VGCH/IV26_device/img/корпус.jpg

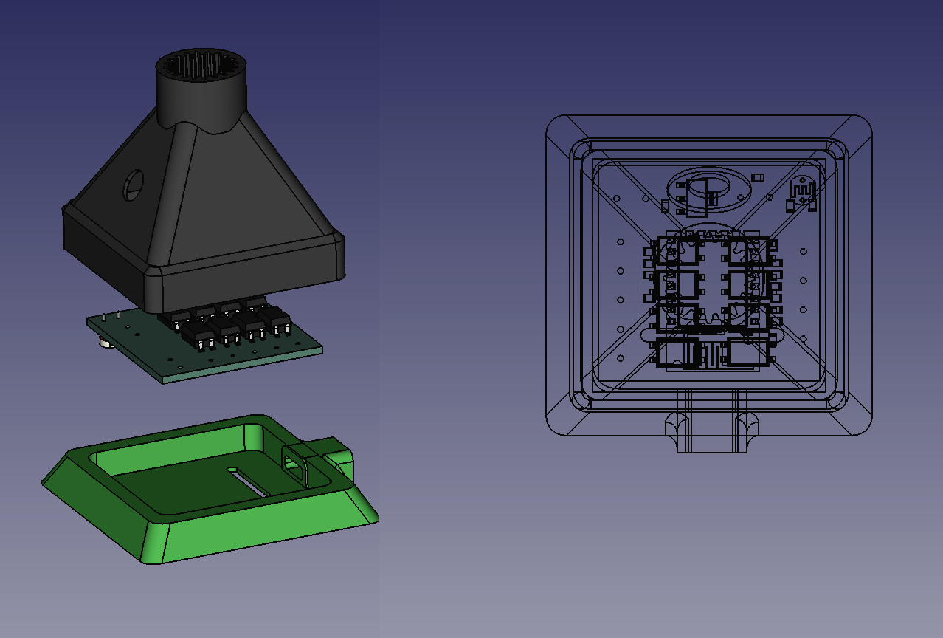
img/корпус.jpg
