VGCH/IV26_device/img/тест_лампы.jpg

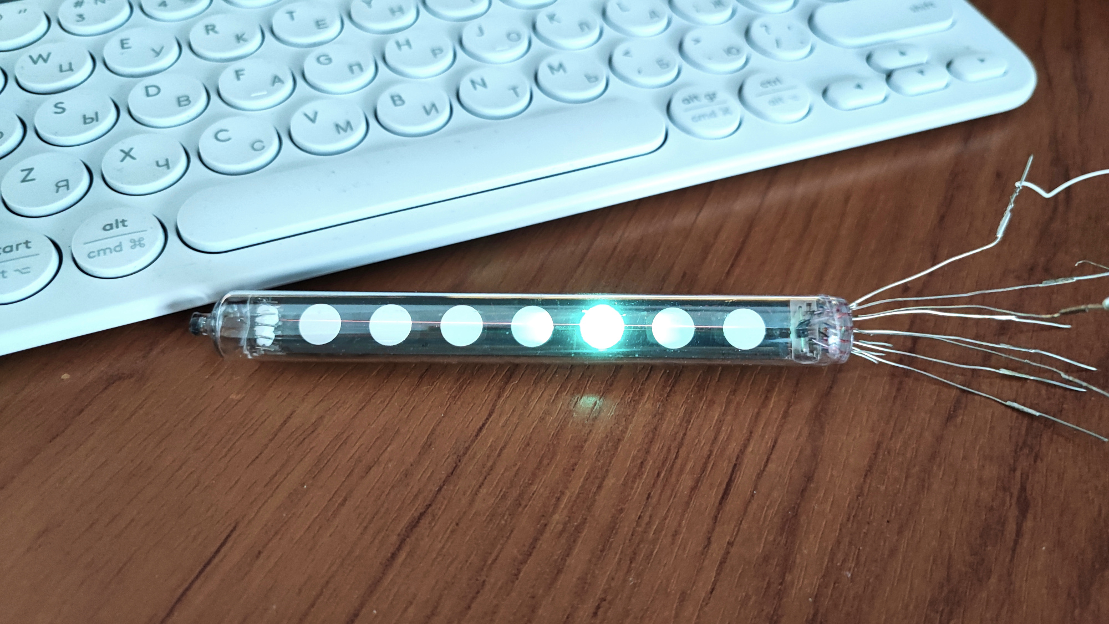
img/тест_лампы.jpg
