VGCH/IV26_device/img/IV26_giagram.png

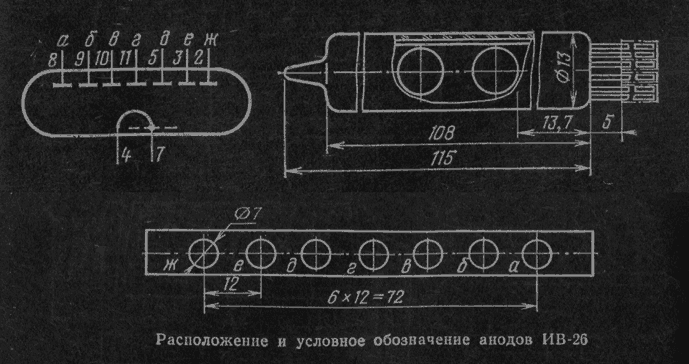
img/IV26_giagram.png
