VGCH/IV26_device/img/горящая_лампа.jpg

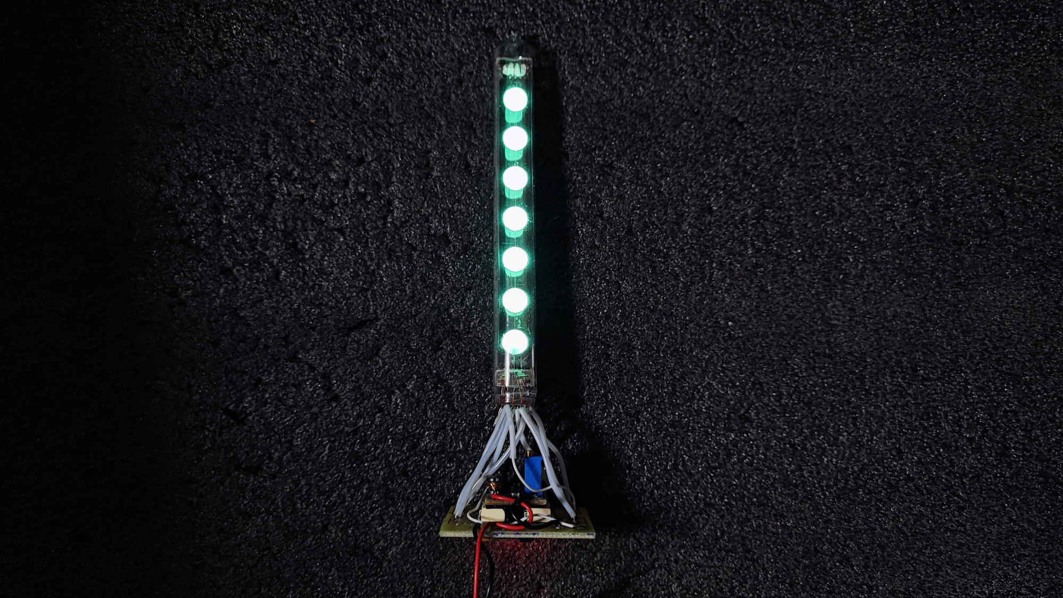
img/горящая_лампа.jpg
