VGCH/IV26_device/img/готовое.jpg

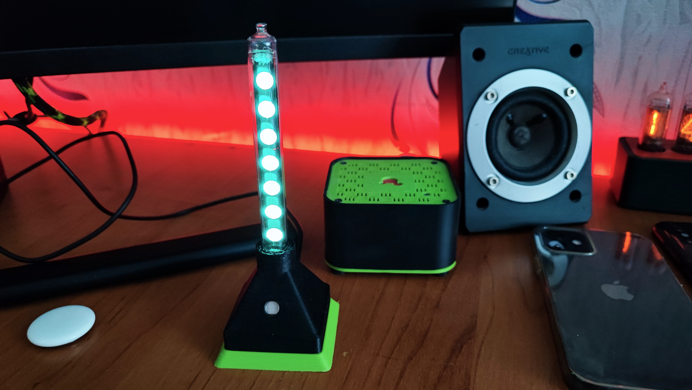
img/готовое.jpg
