VGCH/IV26_device/img/засветка_лазером.jpg

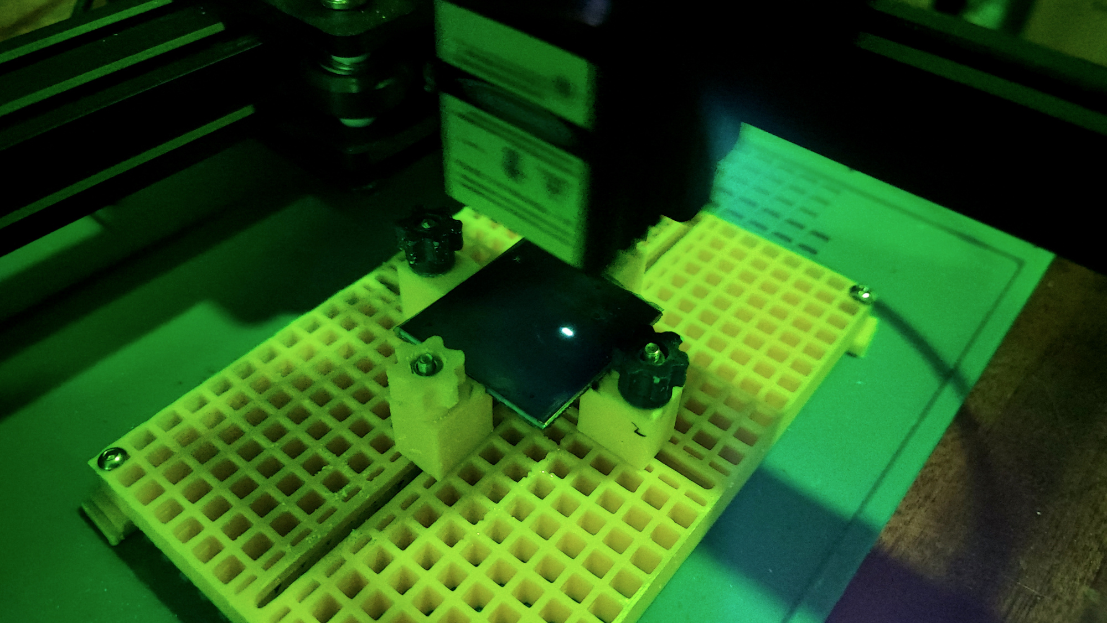
img/засветка_лазером.jpg
