VGCH/IV26_device/img/засвеченная_плата.jpg

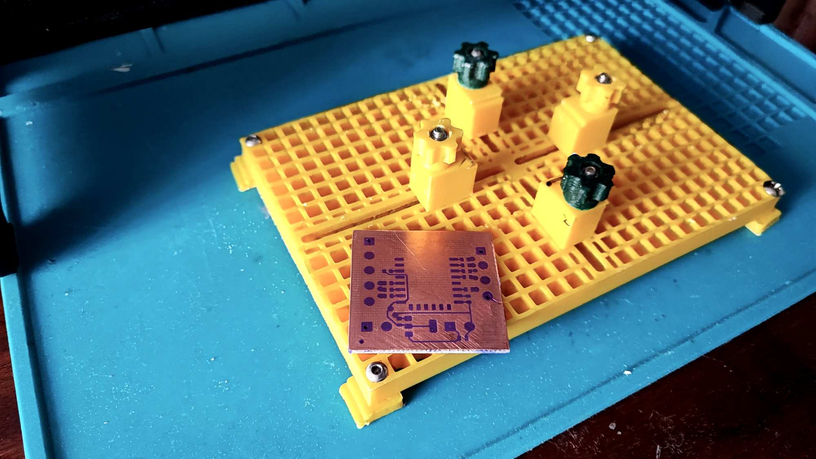
img/засвеченная_плата.jpg
