VGCH/IV26_device/img/интерфейс1.jpg

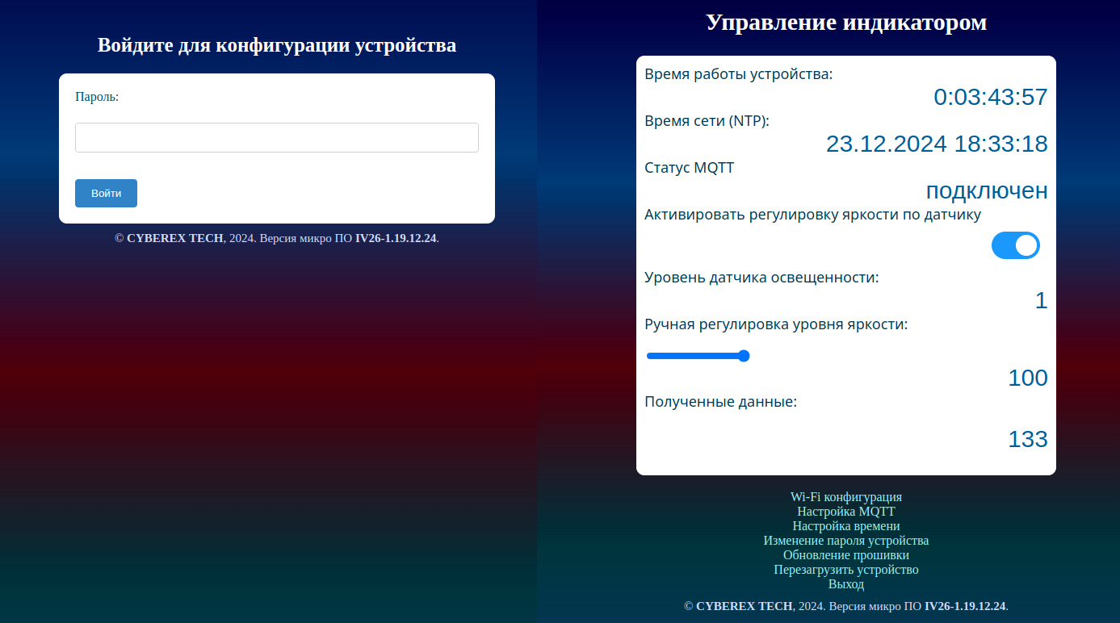
img/интерфейс1.jpg
