VGCH/IV26_device/img/интерфейс2.jpg

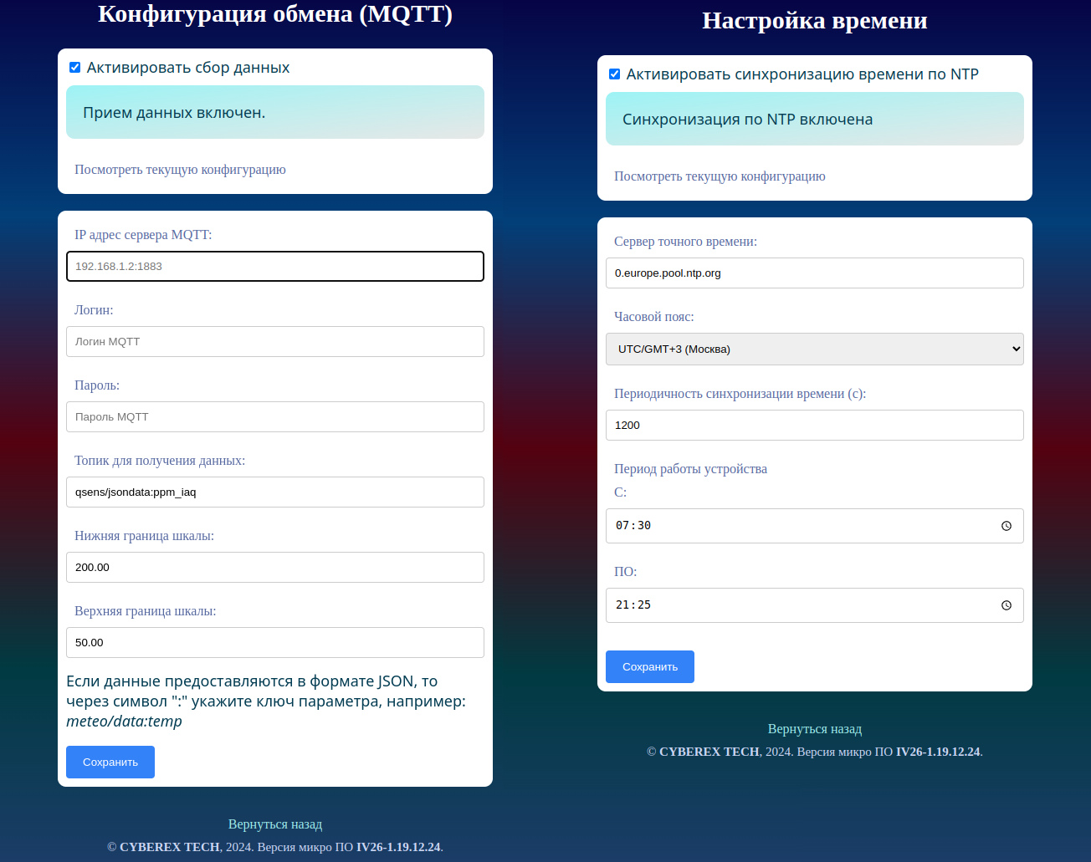
img/интерфейс2.jpg
