VGCH/IV26_device/img/лампа_общий_вид.jpg

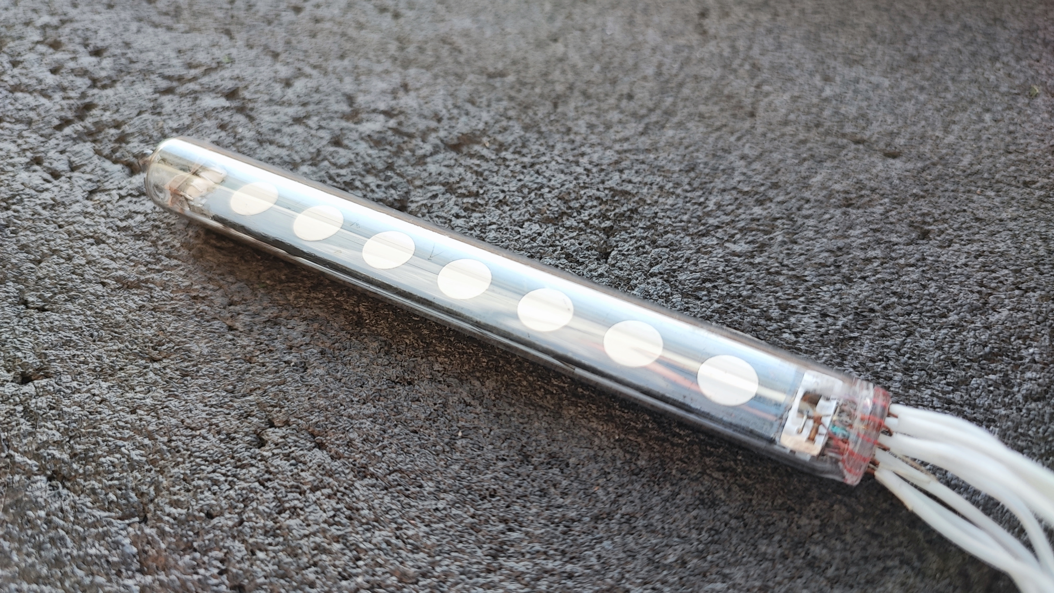
img/лампа_общий_вид.jpg
