VGCH/IV26_device/img/лампа_общий_вид_2.jpg

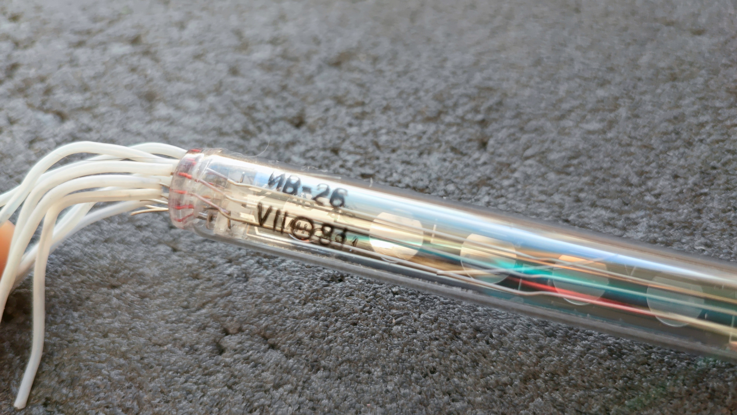
img/лампа_общий_вид_2.jpg
