VGCH/IV26_device/img/Око_Саурона.jpg

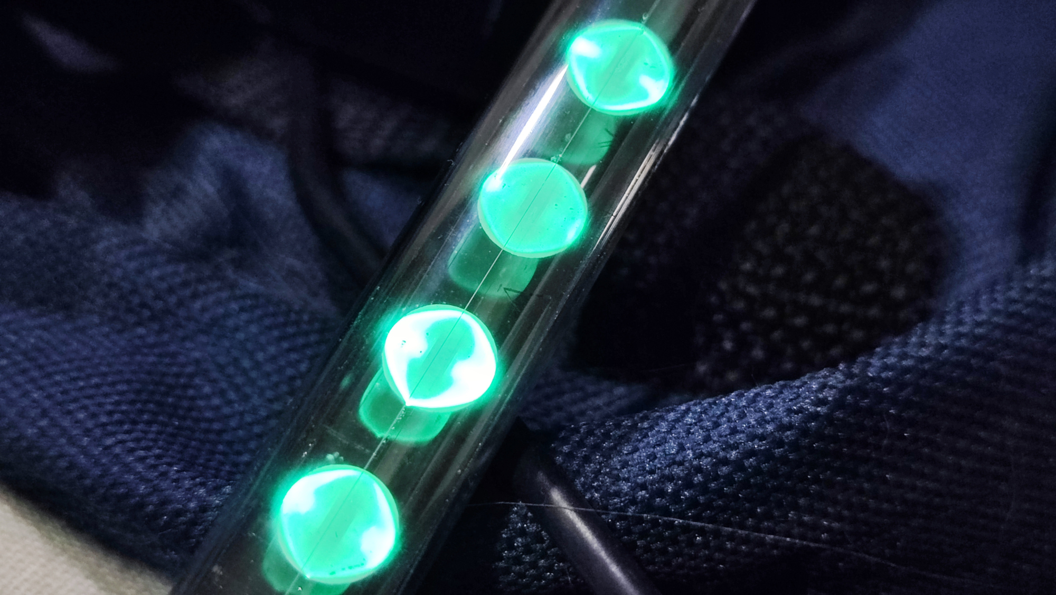
img/Око_Саурона.jpg
