VGCH/IV26_device/img/параметры_ИВ26.jpg

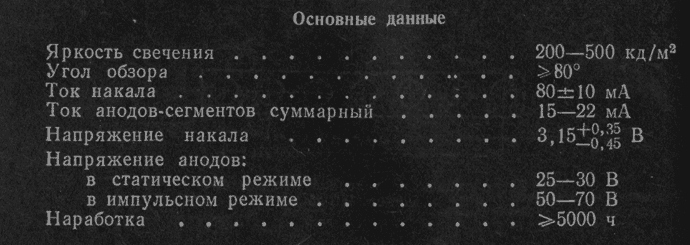
img/параметры_ИВ26.jpg
