VGCH/IV26_device/img/плата.jpg

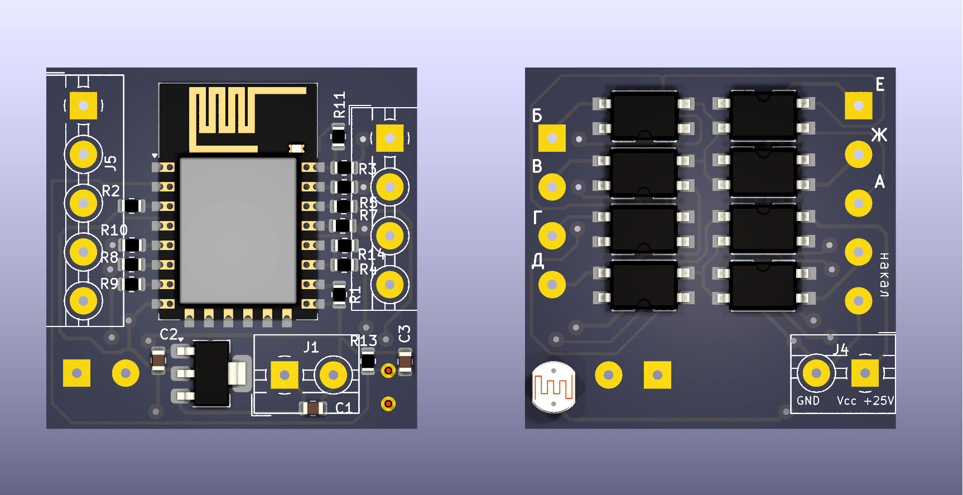
img/плата.jpg
