VGCH/IV26_device/img/подключаем_лампу.jpg

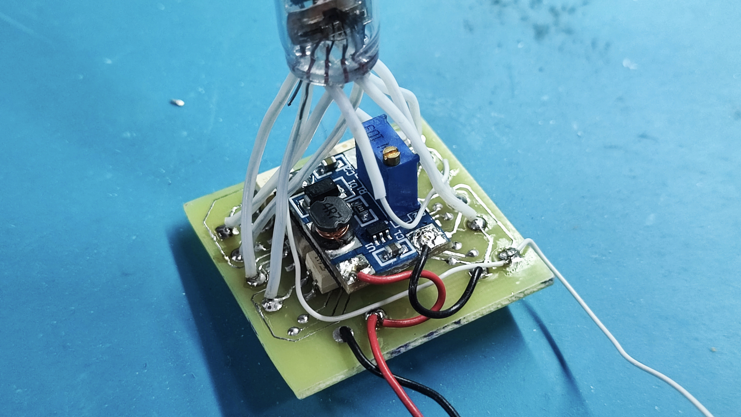
img/подключаем_лампу.jpg
