VGCH/IV26_device/img/подключаем_лампу_виз_сбоку.jpg

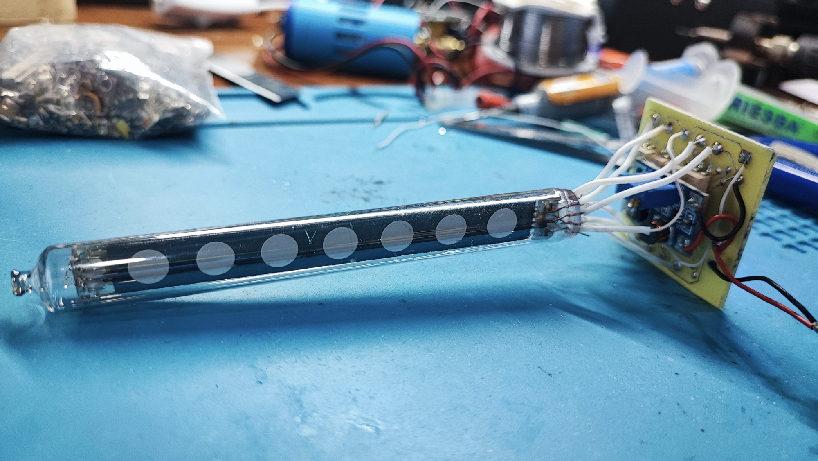
img/подключаем_лампу_виз_сбоку.jpg
