VGCH/IV26_device/img/преобразователь.jpg

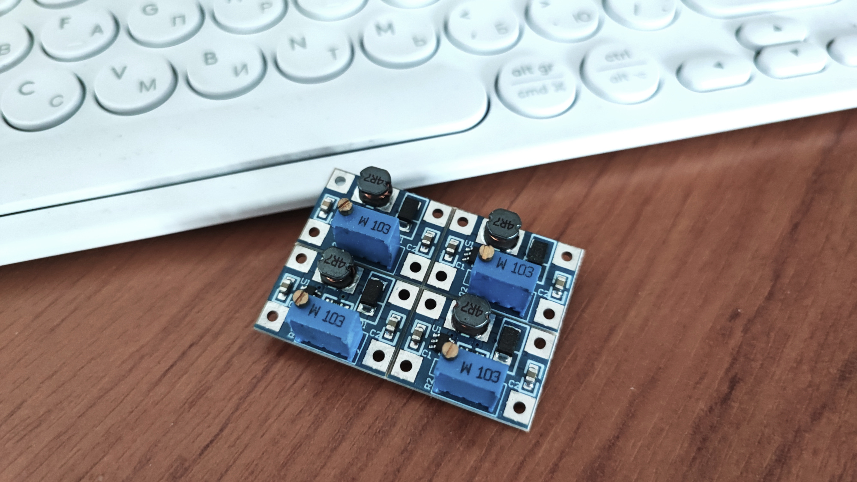
img/преобразователь.jpg
