VGCH/IV26_device/img/сборка_платы_зад.jpg

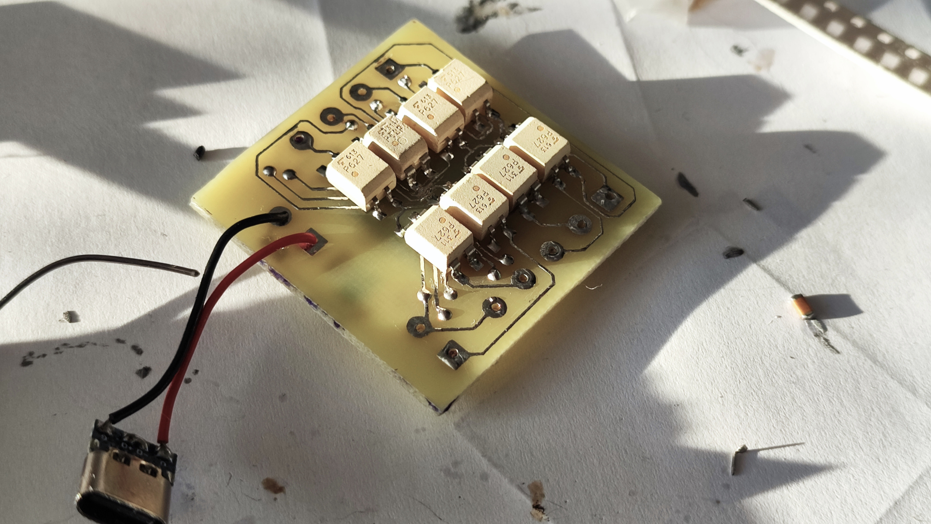
img/сборка_платы_зад.jpg
