VGCH/IV26_device/img/сборка_платы_топ.jpg

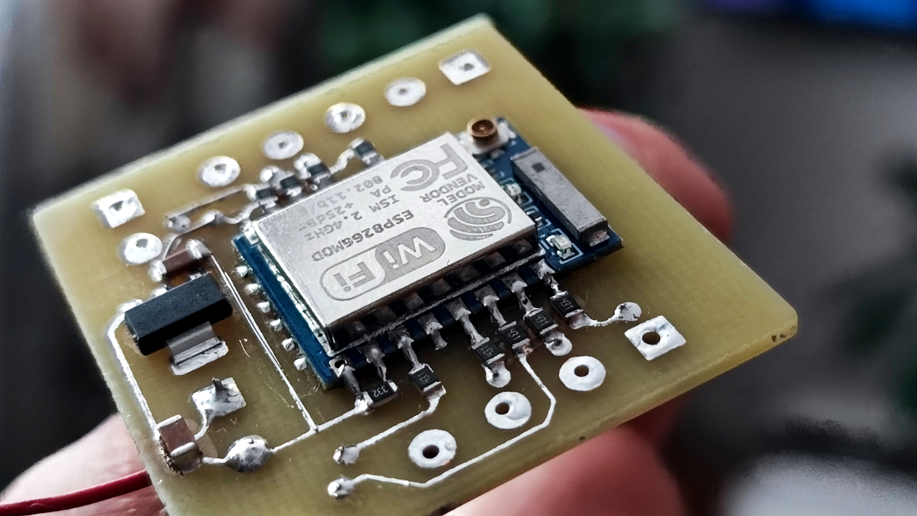
img/сборка_платы_топ.jpg
