VGCH/IV26_device/img/Снимок экрана 2024-12-23 в 19.39.56.png

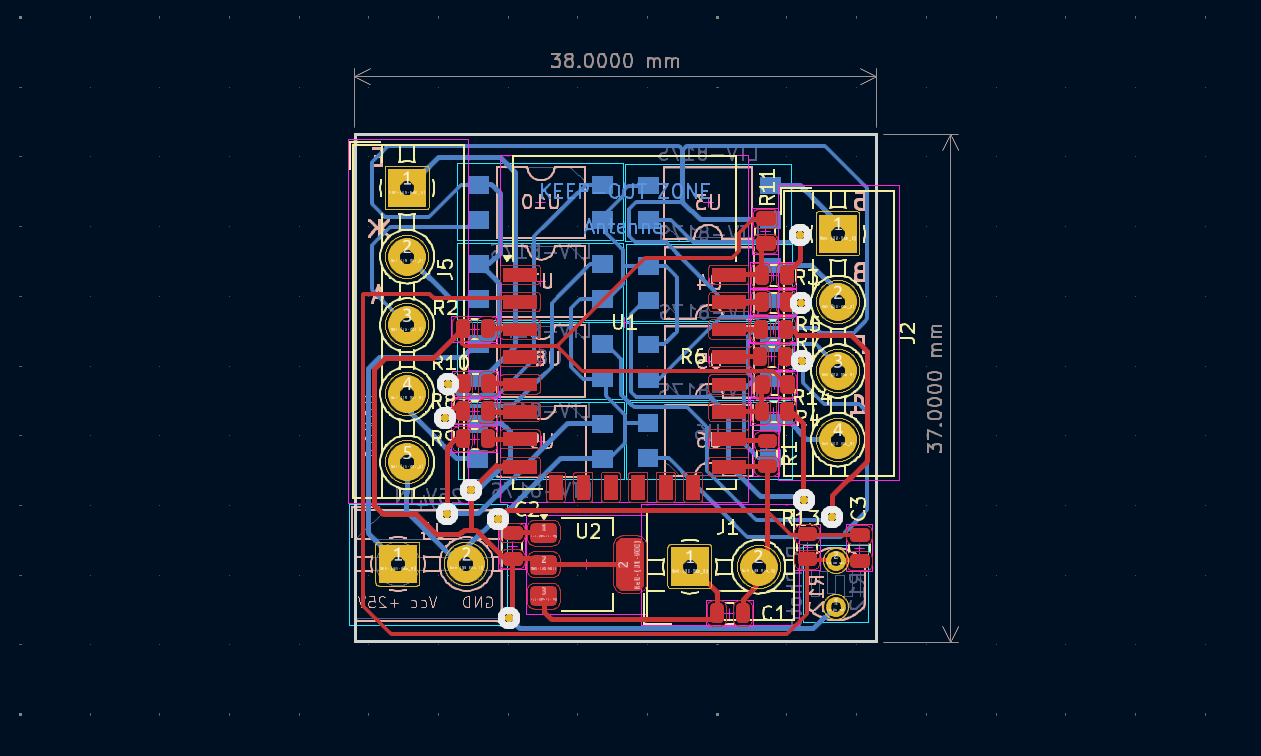
img/Снимок экрана 2024-12-23 в 19.39.56.png
