VGCH/IV26_device/img/схема.jpg

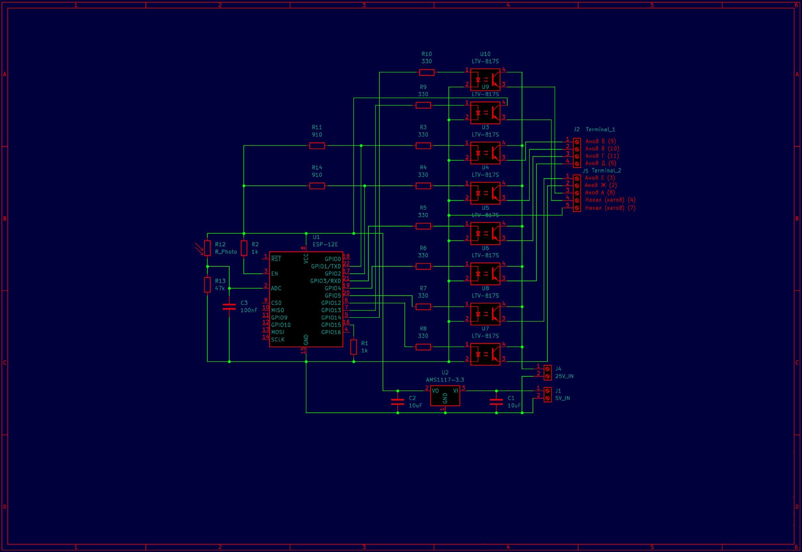
img/схема.jpg
