VGCH/IV26_device/img/фото_резистор.jpg

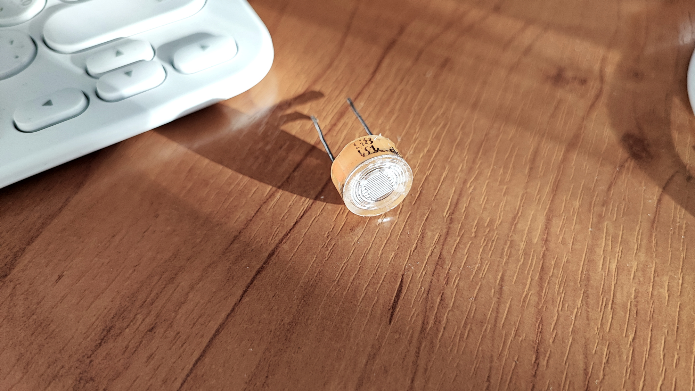
img/фото_резистор.jpg
