VGCH/IV26_device/IV26_board/IV26_board_back.png

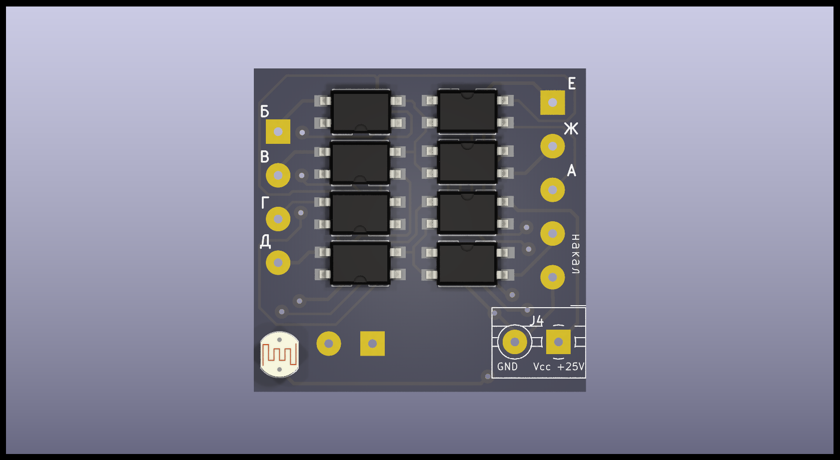
IV26_board/IV26_board_back.png
