VGCH/IV26_device/IV26_board/IV26_board_top.png

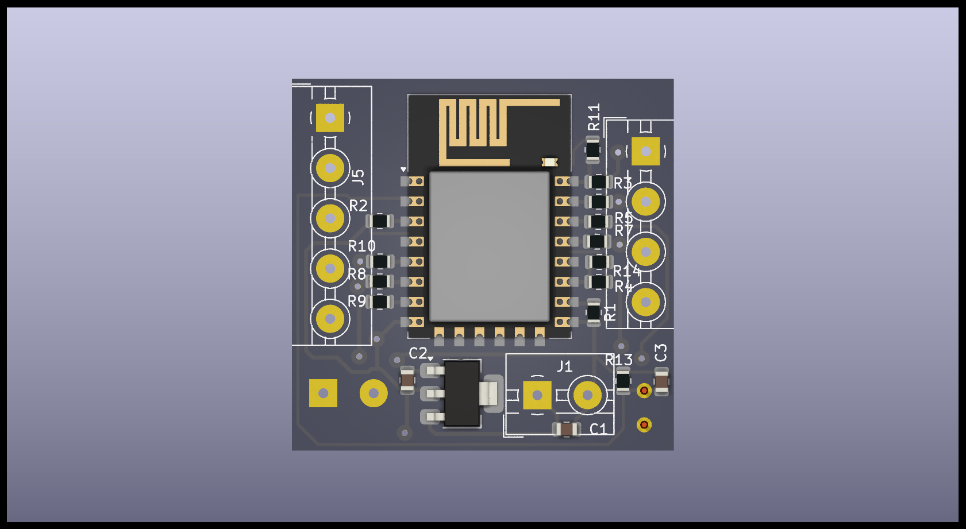
IV26_board/IV26_board_top.png
