VGCH/IV26_device/box/IV26_indicator.FCStd

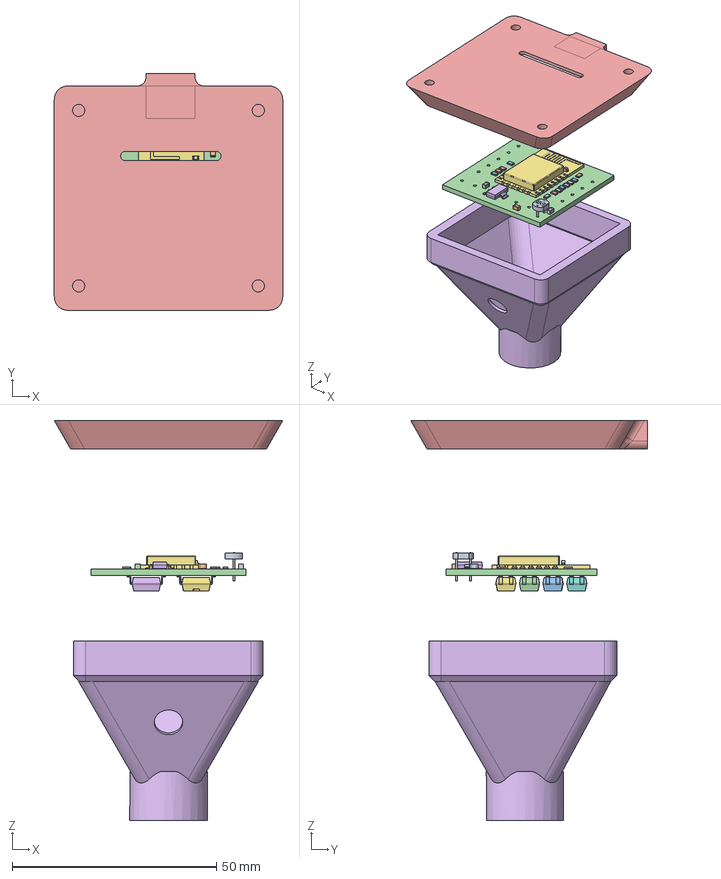
[picture p25: CAD file, 2024-12-24]
box/IV26_indicator.FCStd
56.0 x 58.0 x 98.0 mm
R_0805_2012Metric
R_0805_2012Metric002
R_0805_2012Metric004
R_0805_2012Metric006
R_0805_2012Metric008
SOT_223
R_0805_2012Metric010
R_0805_2012Metric012
C_0805_2012Metric
R_0805_2012Metric014
R_0805_2012Metric016
C_0805_2012Metric002
R_0805_2012Metric018
R_0805_2012Metric020
ESP_12E001_cp
R_0805_2012Metric022
R_LDR_5.1x4.3mm_P3.4mm_Vertical
C_0805_2012Metric004
R_0805_2012Metric024
SMDIP_4_W953mm
SMDIP_4_W953mm001
SMDIP_4_W953mm002
SMDIP_4_W953mm003
SMDIP_4_W953mm004
SMDIP_4_W953mm005
SMDIP_4_W953mm006
SMDIP_4_W953mm007
IV26_board_PCB
