VGCH/IV26_device/box/STL/IV26_indicator-bot.stl

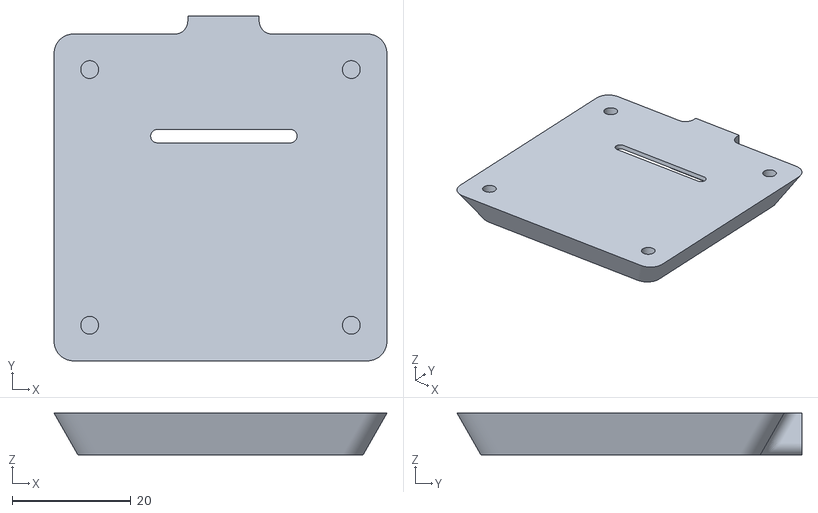
[picture p26: CAD file, 2024-12-24]
box/STL/IV26_indicator-bot.stl
56.0 x 58.0 x 7.00
