VGCH/IV26_device/IV26_board/IV26_board.step

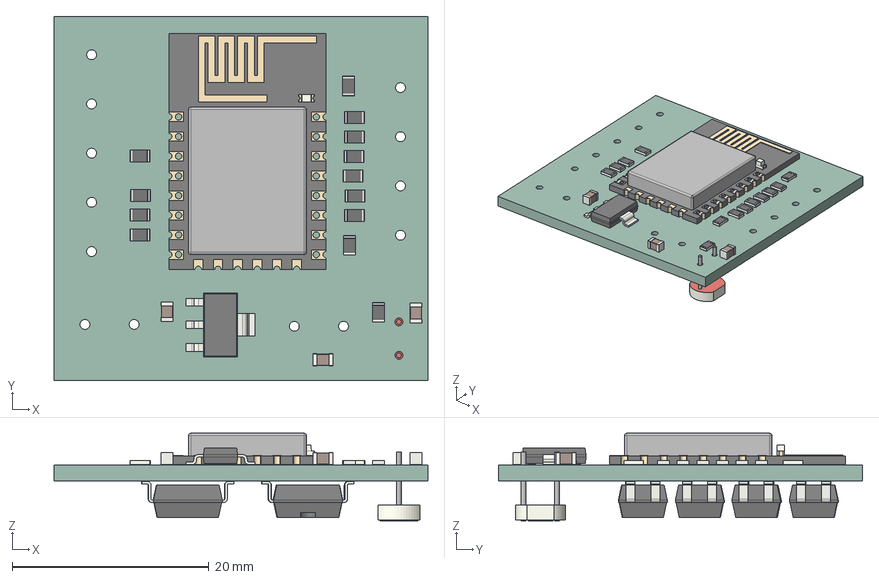
[picture p27: CAD file, 2024-12-24]
IV26_board/IV26_board.step
38.0 x 37.0 x 8.90 mm
R_0805_2012Metric x 13
SOT_223
C_0805_2012Metric x 3
ESP_12E001_cp
SMDIP_4_W953mm x 8
R_LDR_5.1x4.3mm_P3.4mm_Vertical
IV26_board_PCB
