VGCH/IV26_device/box/STL/IV26_indicator-Cut003.stl

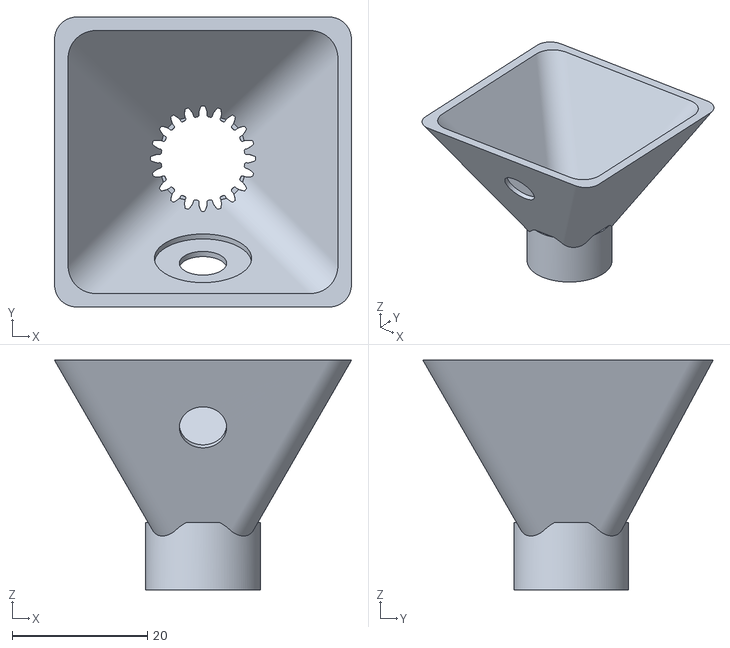
[picture p28: CAD file, 2024-12-24]
box/STL/IV26_indicator-Cut003.stl
44.0 x 43.0 x 34.0
