VGCH/IV26_device/box/STL/IV26_indicator-Chamfer.stl

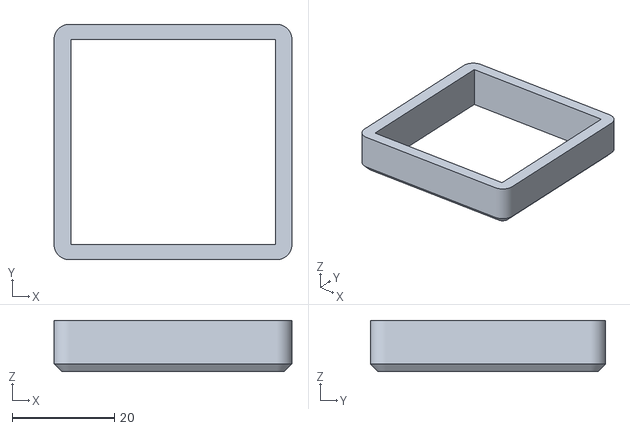
[picture p29: CAD file, 2024-12-24]
box/STL/IV26_indicator-Chamfer.stl
46.5 x 46.0 x 10.0
