VGCH/IV26_device/(list of files, cad)

Other CAD files:
box/STL/IV26_indicator.stl
