VGCH/IV26_device/IV26_board/IV26_board.kicad_pcb

## KiCad design IV26_board/IV26_board.kicad_pcb (2024-12-24)

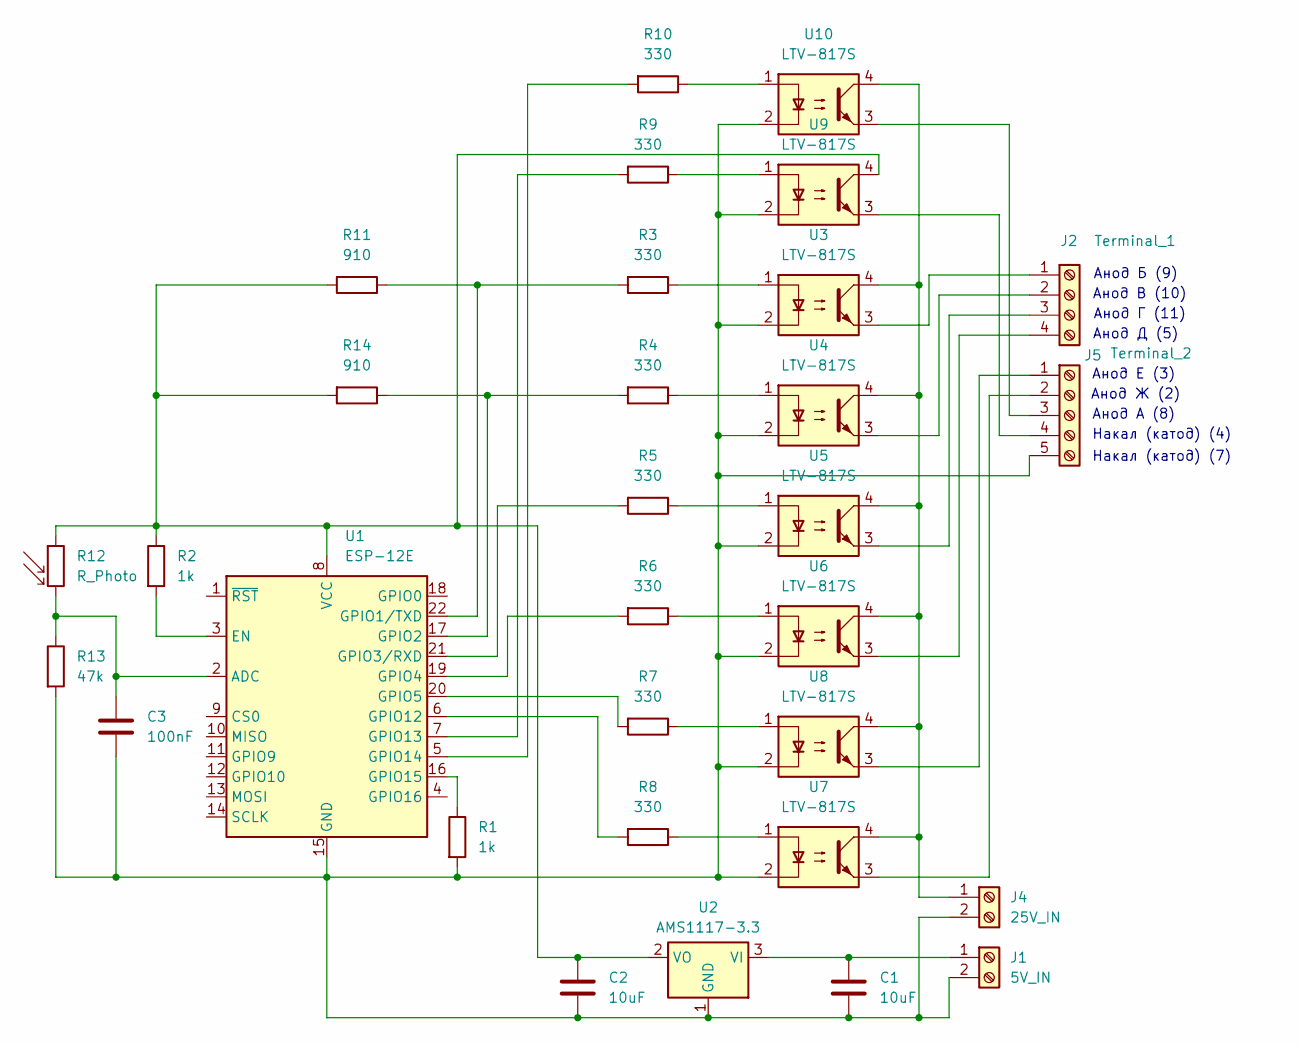
[picture p30: schematic IV26_board.kicad_sch]

Parts:
C1, C2: 10uF; C_0805_2012Metric
C3: 100nF; C_0805_2012Metric
J1: 5V_IN; TerminalBlock_MaiXu_MX126-5.0-02P_1x02_P5.00mm
J2: Terminal_1; TerminalBlock_MaiXu_MX126-5.0-04P_1x04_P5.00mm
J4: 25V_IN; TerminalBlock_MaiXu_MX126-5.0-02P_1x02_P5.00mm
J5: Terminal_2; TerminalBlock_MaiXu_MX126-5.0-05P_1x05_P5.00mm
R1, R2: 1k; R_0805_2012Metric
R3, R4, R5, R6, R7, R8, R9, R10: 330; R_0805_2012Metric
R11, R14: 910; R_0805_2012Metric
R12: R_Photo; R_LDR_5.1x4.3mm_P3.4mm_Vertical
R13: 47k; R_0805_2012Metric
U1: ESP-12E
U2: AMS1117-3.3; SOT-223-3_TabPin2
U3, U4, U5, U6, U7, U8, U9, U10: LTV-817S; SMDIP-4_W9.53mm

Connections:
unnamed: C1.1, J1.1, U2.3 (VI)
unnamed: C1.2, C2.2, C3.2, J1.2, J4.2, J5.5, R1.2, R13.2, U1.15 (GND), U2.1 (GND), U3.2, U4.2, U5.2, U6.2, U7.2, U8.2, U9.2, U10.2
unnamed: J2.1, U3.3
unnamed: J2.2, U4.3
unnamed: J2.3, U5.3
unnamed: J2.4, U6.3
unnamed: J4.1, U3.4, U4.4, U5.4, U6.4, U7.4, U8.4, U10.4
unnamed: J5.1, U8.3
unnamed: J5.2, U7.3
unnamed: J5.3, U10.3
unnamed: J5.4, U9.3
unnamed: R3.1, U3.1
unnamed: R4.1, U4.1
unnamed: R5.1, U5.1
unnamed: R6.1, U6.1
unnamed: R7.1, U8.1
unnamed: R8.1, U7.1
unnamed: R9.1, U9.1
unnamed: R10.1, U10.1
unnamed: C3.1, R12.2, R13.1, U1.2 (ADC)
unnamed: R2.2, U1.3 (EN)
unnamed: R3.2, R11.1, U1.22 (GPIO1/TXD)
unnamed: R4.2, R14.1, U1.17 (GPIO2)
unnamed: R5.2, U1.21 (GPIO3/RXD)
unnamed: R6.2, U1.19 (GPIO4)
unnamed: R7.2, U1.20 (GPIO5)
unnamed: R8.2, U1.6 (GPIO12)
unnamed: R9.2, U1.7 (GPIO13)
unnamed: R10.2, U1.5 (GPIO14)
unnamed: R1.1, U1.16 (GPIO15)
unnamed: C2.1, R2.1, R11.2, R12.1, R14.2, U1.8 (VCC), U2.2 (VO), U9.4

Notes on the sheet:
Анод А (8)
Анод Г (11)
Анод Б (9)
Анод В (10)
Анод Д (5)
Накал (катод) (7)
Анод Ж (2)
Накал (катод) (4)
Анод Е (3)

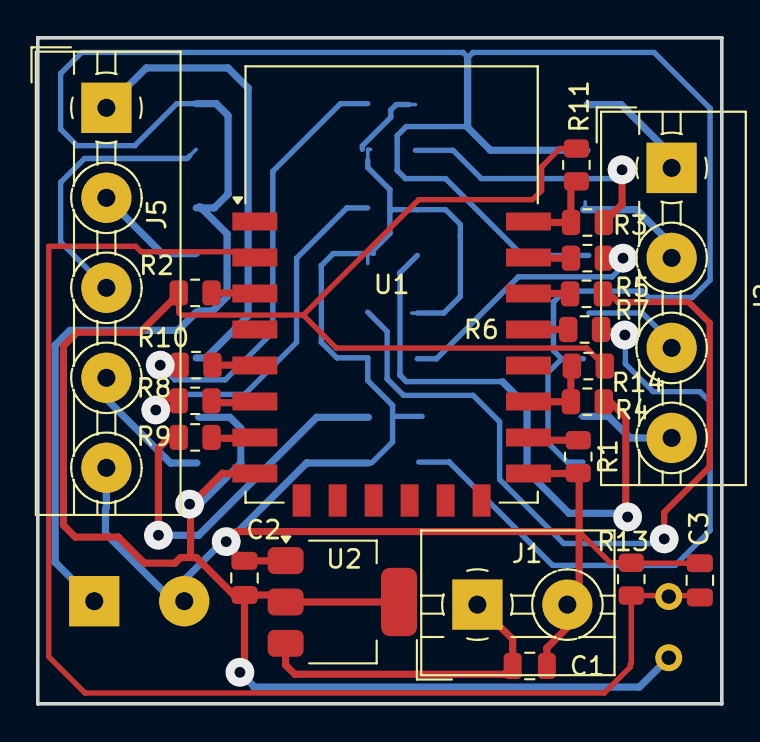
[picture p31: board IV26_board.kicad_pcb from above]

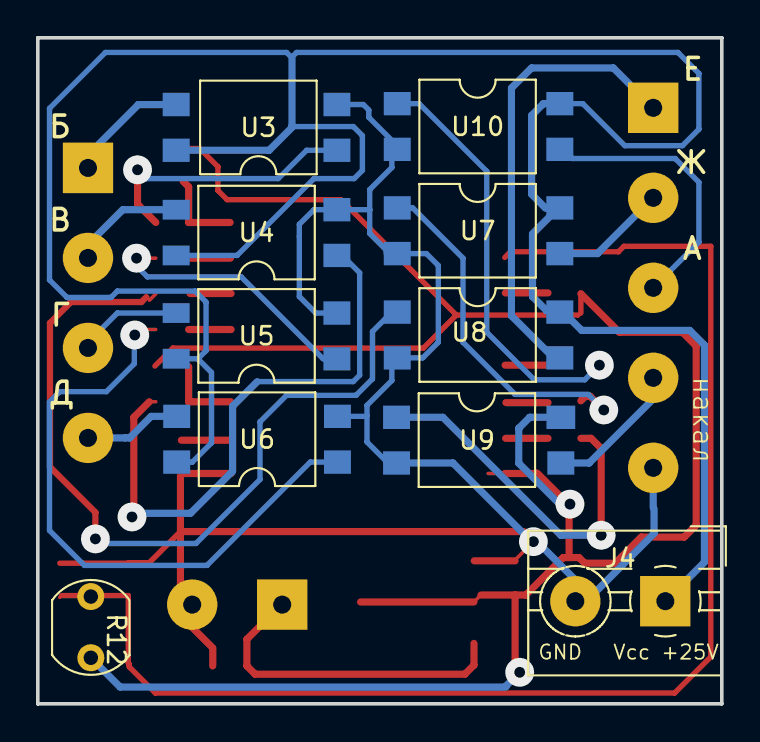
[picture p32: board IV26_board.kicad_pcb from below]

Board: 2 copper layers, 38.0 x 37.0 mm, 31 parts (10 on the bottom side), 31 nets.
